EPSILON0-dev/pico-pdu/pcb/pico-pdu.kicad_pcb

## KiCad design pcb/pico-pdu.kicad_pcb (2026-10-05)

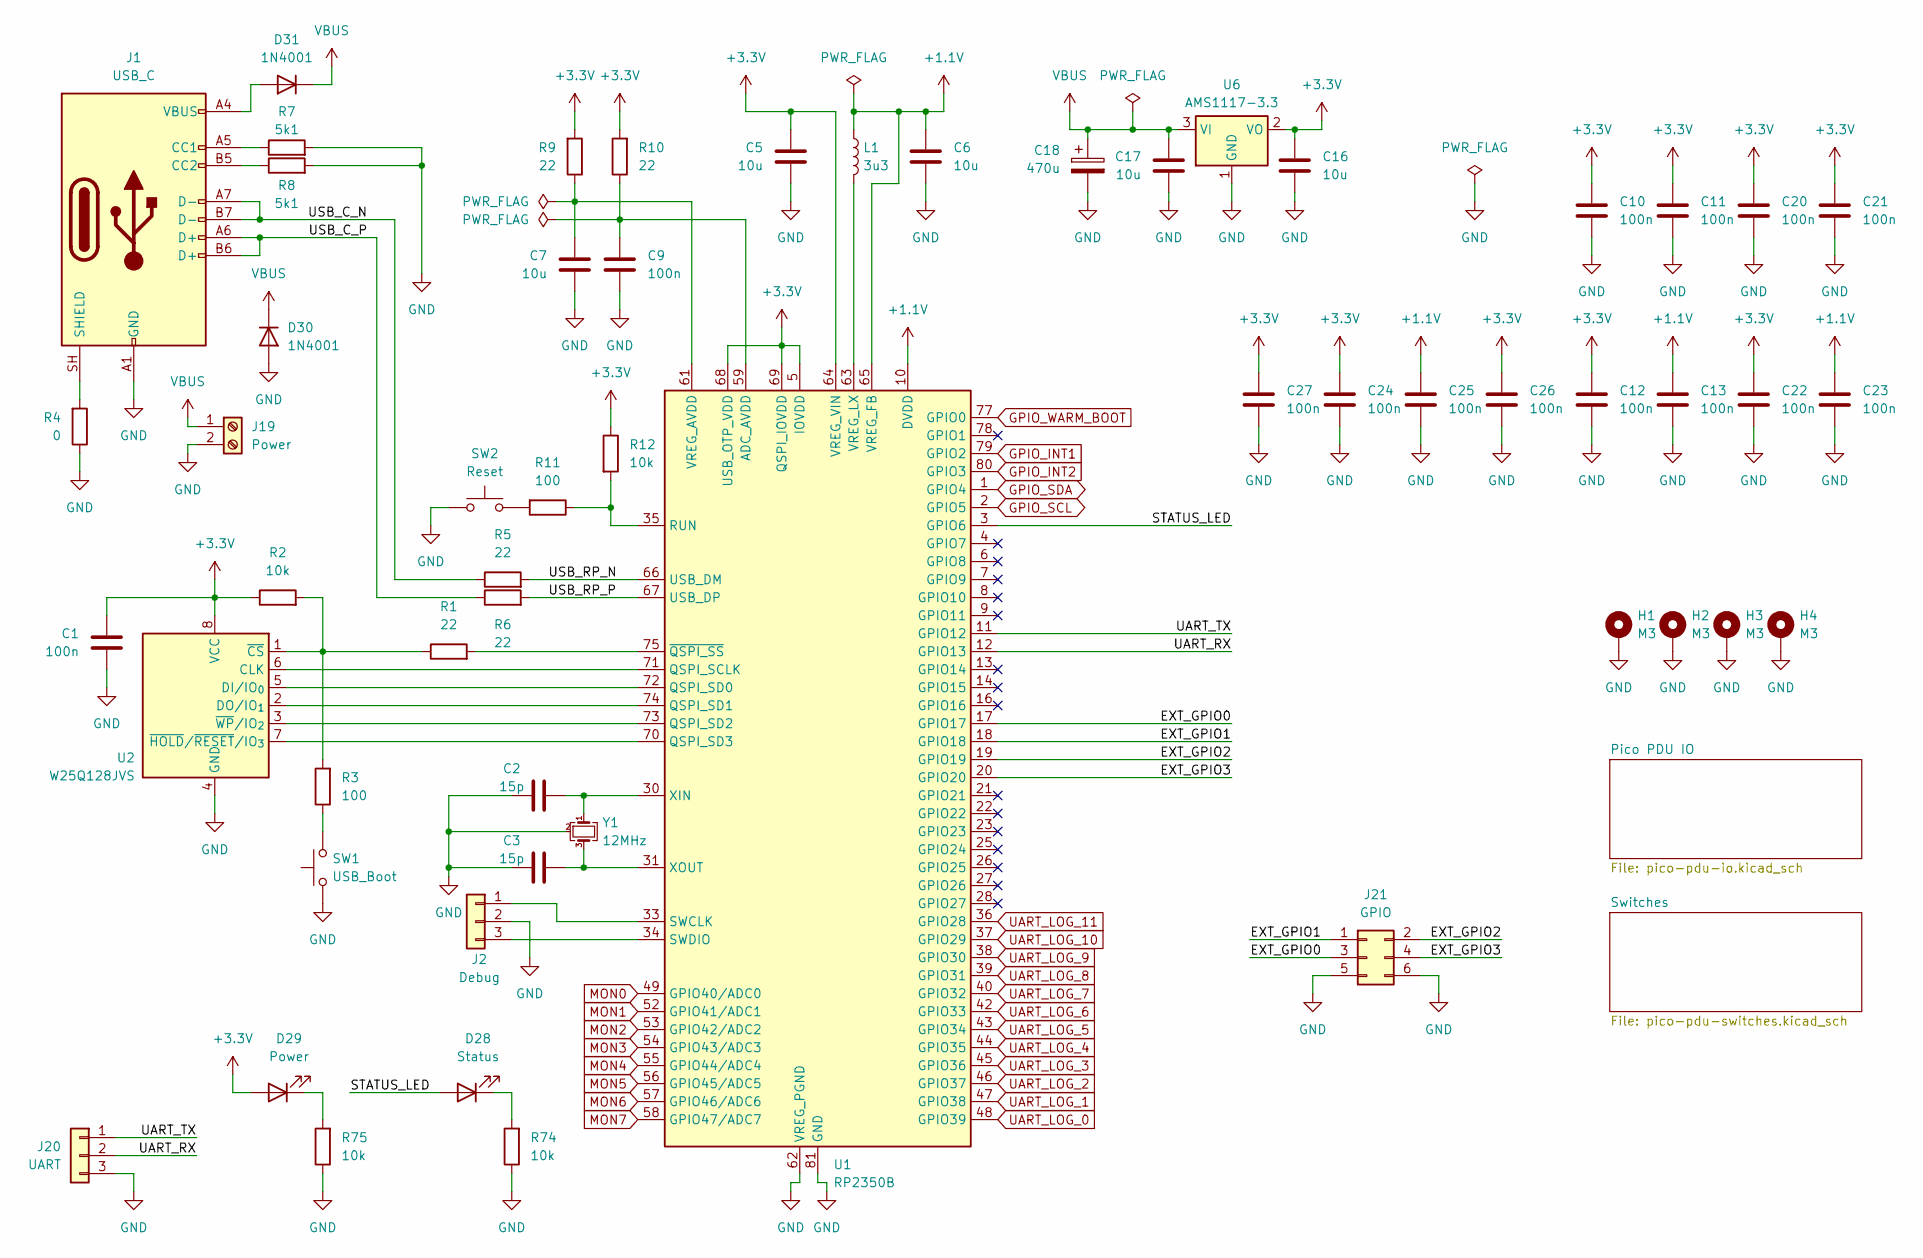
[picture p3: schematic pico-pdu.kicad_sch, Pico PDU MCU]

Parts:
C1, C9, C10, C11, C12, C13, C20, C21, C22, C23, C24, C25, C26, C27: 100n; C_0402_1005Metric
C2, C3: 15p; C_0402_1005Metric
C5, C6, C7, C16, C17: 10u; C_0603_1608Metric
C18: 470u; CP_Radial_D10.0mm_P5.00mm
D28: Status; LED_0805_2012Metric
D29: Power; LED_0805_2012Metric
D30, D31: 1N4001; D_DO-41_SOD81_P10.16mm_Horizontal
H1, H2, H3, H4: M3; MountingHole_3.2mm_M3_Pad_Via
J1: USB_C; USB_C_Receptacle_G-Switch_GT-USB-7010ASV
J2: Debug; PinHeader_1x03_P2.54mm_Vertical
J19: Power; TerminalBlock_MaiXu_MX126-5.0-02P_1x02_P5.00mm
J20: UART; PinHeader_1x03_P2.54mm_Vertical
J21: GPIO; PinHeader_2x03_P2.54mm_Vertical
L1: 3u3; L_1008_2520Metric
R1, R5, R6, R9, R10: 22; R_0402_1005Metric
R2, R12, R74, R75: 10k; R_0402_1005Metric
R3, R11: 100; R_0402_1005Metric
R4: 0; R_0402_1005Metric
R7, R8: 5k1; R_0402_1005Metric
SW1: USB_Boot; SW_Push_SPST_NO_Alps_SKRK
SW2: Reset; SW_Push_SPST_NO_Alps_SKRK
U1: RP2350B; QFN-80-1EP_10x10mm_P0.4mm_EP3.4x3.4mm
U2: W25Q128JVS; WSON-8-1EP_6x5mm_P1.27mm_EP3.4x4mm
U6: AMS1117-3.3; SOT-223-3_TabPin2
Y1: 12MHz; Crystal_SMD_2520-4Pin_2.5x2.0mm

Connections:
+1.1V: C6.1, C13.1, C23.1, C25.1, L1.1, U1.10 (DVDD), U1.32 (DVDD), U1.51 (DVDD), U1.65 (VREG_FB)
+3.3V: C1.1, C5.2, C10.1, C11.1, C12.1, C16.1, C20.1, C21.1, C22.1, C24.1, C26.1, C27.1, D29.2 (A), R2.1, R9.2, R10.2, R12.1, U1.5 (IOVDD), U1.15 (IOVDD), U1.24 (IOVDD), U1.29 (IOVDD), U1.41 (IOVDD), U1.50 (IOVDD), U1.60 (IOVDD), U1.64 (VREG_VIN), U1.68 (USB_OTP_VDD), U1.69 (QSPI_IOVDD), U1.76 (IOVDD), U2.8 (VCC), U6.2 (VO); also elsewhere on the board
/EXT_GPIO0: J21.3, U1.17 (GPIO17)
/EXT_GPIO1: J21.1, U1.18 (GPIO18)
/EXT_GPIO2: J21.2, U1.19 (GPIO19)
/EXT_GPIO3: J21.4, U1.20 (GPIO20)
/STATUS_LED: D28.2 (A), U1.3 (GPIO6)
/UART_RX: J20.2, U1.12 (GPIO13)
/UART_TX: J20.1, U1.11 (GPIO12)
/USB_C_N: J1.A7 (D-), J1.B7 (D-), R5.1
/USB_C_P: J1.A6 (D+), J1.B6 (D+), R6.1
/USB_RP_N: R5.2, U1.66 (USB_DM)
/USB_RP_P: R6.2, U1.67 (USB_DP)
GND: C1.2, C2.1, C3.1, C5.1, C6.2, C7.2, C9.2, C10.2, C11.2, C12.2, C13.2, C16.2, C17.2, C18.2, C20.2, C21.2, C22.2, C23.2, C24.2, C25.2, C26.2, C27.2, D30.2 (A), H1.1 (1_1), H2.1 (1_1), H3.1 (1_1), H4.1 (1_1), J1.A1 (GND), J1.A12 (GND), J1.B1 (GND), J1.B12 (GND), J2.2, J19.2, J20.3, J21.5, J21.6, R4.1, R7.2, R8.2, R74.1, R75.1, SW1.1, SW2.2, U1.62 (VREG_PGND), U1.81 (GND), U2.4 (GND), U6.1 (GND), Y1.2 (G), Y1.4 (G); also elsewhere on the board
GPIO_INT1: U1.79 (GPIO2); also elsewhere on the board
GPIO_INT2: U1.80 (GPIO3); also elsewhere on the board
GPIO_SCL: U1.2 (GPIO5); also elsewhere on the board
GPIO_SDA: U1.1 (GPIO4); also elsewhere on the board
GPIO_WARM_BOOT: U1.77 (GPIO0); also elsewhere on the board
MON0: U1.49 (GPIO40/ADC0); also elsewhere on the board
MON1: U1.52 (GPIO41/ADC1); also elsewhere on the board
MON2: U1.53 (GPIO42/ADC2); also elsewhere on the board
MON3: U1.54 (GPIO43/ADC3); also elsewhere on the board
MON4: U1.55 (GPIO44/ADC4); also elsewhere on the board
MON5: U1.56 (GPIO45/ADC5); also elsewhere on the board
MON6: U1.57 (GPIO46/ADC6); also elsewhere on the board
MON7: U1.58 (GPIO47/ADC7); also elsewhere on the board
unnamed: D28.1 (K), R74.2
unnamed: D29.1 (K), R75.2
unnamed: D31.2 (A), J1.A4 (VBUS), J1.A9 (VBUS), J1.B4 (VBUS), J1.B9 (VBUS)
unnamed: J1.A5 (CC1), R7.1
unnamed: J1.B5 (CC2), R8.1
unnamed: J1.SH (SHIELD), R4.2
unnamed: J2.1, U1.33 (SWCLK)
unnamed: J2.3, U1.34 (SWDIO)
unnamed: R3.1, SW1.2
unnamed: R11.2, SW2.1
unnamed: C9.1, R10.1, U1.59 (ADC_AVDD)
unnamed: U1.71 (QSPI_SCLK), U2.6 (CLK)
unnamed: U1.72 (QSPI_SD0), U2.5 (DI/IO_{0})
unnamed: U1.74 (QSPI_SD1), U2.2 (DO/IO_{1})
unnamed: U1.73 (QSPI_SD2), U2.3 (~WP/IO_{2})
unnamed: U1.70 (QSPI_SD3), U2.7 (~HOLD/~RESET/IO_{3})
unnamed: R11.1, R12.2, U1.35 (RUN)
unnamed: C7.1, R9.1, U1.61 (VREG_AVDD)
unnamed: L1.2, U1.63 (VREG_LX)
unnamed: C2.2, U1.30 (XIN), Y1.1
unnamed: C3.2, U1.31 (XOUT), Y1.3
unnamed: R1.2, U1.75 (~QSPI_SS)
unnamed: R1.1, R2.2, R3.2, U2.1 (~CS)
UART_LOG_0: U1.48 (GPIO39); also elsewhere on the board
UART_LOG_1: U1.47 (GPIO38); also elsewhere on the board
UART_LOG_2: U1.46 (GPIO37); also elsewhere on the board
UART_LOG_3: U1.45 (GPIO36); also elsewhere on the board
UART_LOG_4: U1.44 (GPIO35); also elsewhere on the board
UART_LOG_5: U1.43 (GPIO34); also elsewhere on the board
UART_LOG_6: U1.42 (GPIO33); also elsewhere on the board
UART_LOG_7: U1.40 (GPIO32); also elsewhere on the board
UART_LOG_8: U1.39 (GPIO31); also elsewhere on the board
UART_LOG_9: U1.38 (GPIO30); also elsewhere on the board
UART_LOG_10: U1.37 (GPIO29); also elsewhere on the board
UART_LOG_11: U1.36 (GPIO28); also elsewhere on the board
VBUS: C17.1, C18.1, D30.1 (K), D31.1 (K), J19.1, U6.3 (VI)

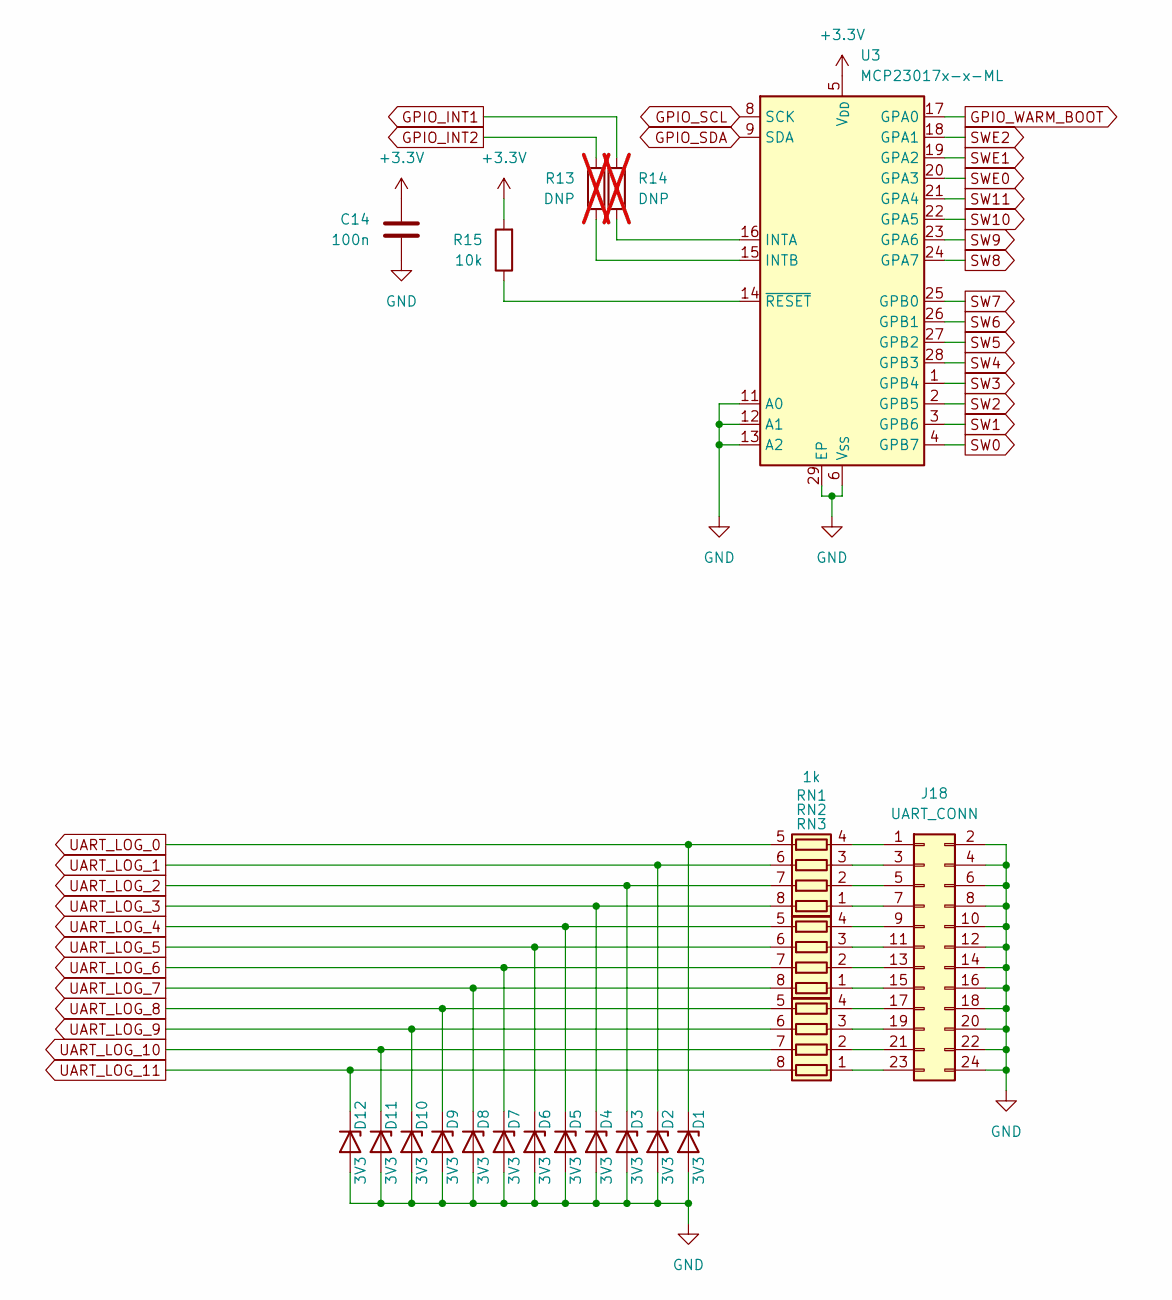
[picture p4: schematic pico-pdu-io.kicad_sch, Pico PDU IO]

Parts:
C14: 100n; C_0402_1005Metric
D1, D2, D3, D4, D5, D6, D7, D8, D9, D10, D11, D12: 3V3; D_MicroMELF
J18: UART_CONN; PinHeader_2x12_P2.54mm_Vertical
R13, R14: DNP; R_0402_1005Metric; not fitted
R15: 10k; R_0402_1005Metric
RN1, RN2, RN3: 1k; R_Array_Concave_4x0402
U3: MCP23017x-x-ML; QFN-28-1EP_6x6mm_P0.65mm_EP4.25x4.25mm

Connections:
+3.3V: C14.1, R15.2, U3.5 (V_{DD}); also elsewhere on the board
GND: C14.2, D1.2 (A), D2.2 (A), D3.2 (A), D4.2 (A), D5.2 (A), D6.2 (A), D7.2 (A), D8.2 (A), D9.2 (A), D10.2 (A), D11.2 (A), D12.2 (A), J18.2, J18.4, J18.6, J18.8, J18.10, J18.12, J18.14, J18.16, J18.18, J18.20, J18.22, J18.24, U3.6 (V_{SS}), U3.11 (A0), U3.12 (A1), U3.13 (A2), U3.29 (EP); also elsewhere on the board
GPIO_INT1: R14.2; also elsewhere on the board
GPIO_INT2: R13.2; also elsewhere on the board
GPIO_SCL: U3.8 (SCK); also elsewhere on the board
GPIO_SDA: U3.9 (SDA); also elsewhere on the board
GPIO_WARM_BOOT: U3.17 (GPA0); also elsewhere on the board
unnamed: J18.1, RN1.4 (R4.1)
unnamed: J18.3, RN1.3 (R3.1)
unnamed: J18.5, RN1.2 (R2.1)
unnamed: J18.7, RN1.1 (R1.1)
unnamed: J18.9, RN2.4 (R4.1)
unnamed: J18.11, RN2.3 (R3.1)
unnamed: J18.13, RN2.2 (R2.1)
unnamed: J18.15, RN2.1 (R1.1)
unnamed: J18.17, RN3.4 (R4.1)
unnamed: J18.19, RN3.3 (R3.1)
unnamed: J18.21, RN3.2 (R2.1)
unnamed: J18.23, RN3.1 (R1.1)
unnamed: R14.1, U3.16 (INTA)
unnamed: R13.1, U3.15 (INTB)
unnamed: R15.1, U3.14 (~RESET)
SW0: U3.4 (GPB7); also elsewhere on the board
SW1: U3.3 (GPB6); also elsewhere on the board
SW2: U3.2 (GPB5); also elsewhere on the board
SW3: U3.1 (GPB4); also elsewhere on the board
SW4: U3.28 (GPB3); also elsewhere on the board
SW5: U3.27 (GPB2); also elsewhere on the board
SW6: U3.26 (GPB1); also elsewhere on the board
SW7: U3.25 (GPB0); also elsewhere on the board
SW8: U3.24 (GPA7); also elsewhere on the board
SW9: U3.23 (GPA6); also elsewhere on the board
SW10: U3.22 (GPA5); also elsewhere on the board
SW11: U3.21 (GPA4); also elsewhere on the board
SWE0: U3.20 (GPA3); also elsewhere on the board
SWE1: U3.19 (GPA2); also elsewhere on the board
SWE2: U3.18 (GPA1); also elsewhere on the board
UART_LOG_0: D1.1 (K), RN1.5 (R4.2); also elsewhere on the board
UART_LOG_1: D2.1 (K), RN1.6 (R3.2); also elsewhere on the board
UART_LOG_2: D3.1 (K), RN1.7 (R2.2); also elsewhere on the board
UART_LOG_3: D4.1 (K), RN1.8 (R1.2); also elsewhere on the board
UART_LOG_4: D5.1 (K), RN2.5 (R4.2); also elsewhere on the board
UART_LOG_5: D6.1 (K), RN2.6 (R3.2); also elsewhere on the board
UART_LOG_6: D7.1 (K), RN2.7 (R2.2); also elsewhere on the board
UART_LOG_7: D8.1 (K), RN2.8 (R1.2); also elsewhere on the board
UART_LOG_8: D9.1 (K), RN3.5 (R4.2); also elsewhere on the board
UART_LOG_9: D10.1 (K), RN3.6 (R3.2); also elsewhere on the board
UART_LOG_10: D11.1 (K), RN3.7 (R2.2); also elsewhere on the board
UART_LOG_11: D12.1 (K), RN3.8 (R1.2); also elsewhere on the board

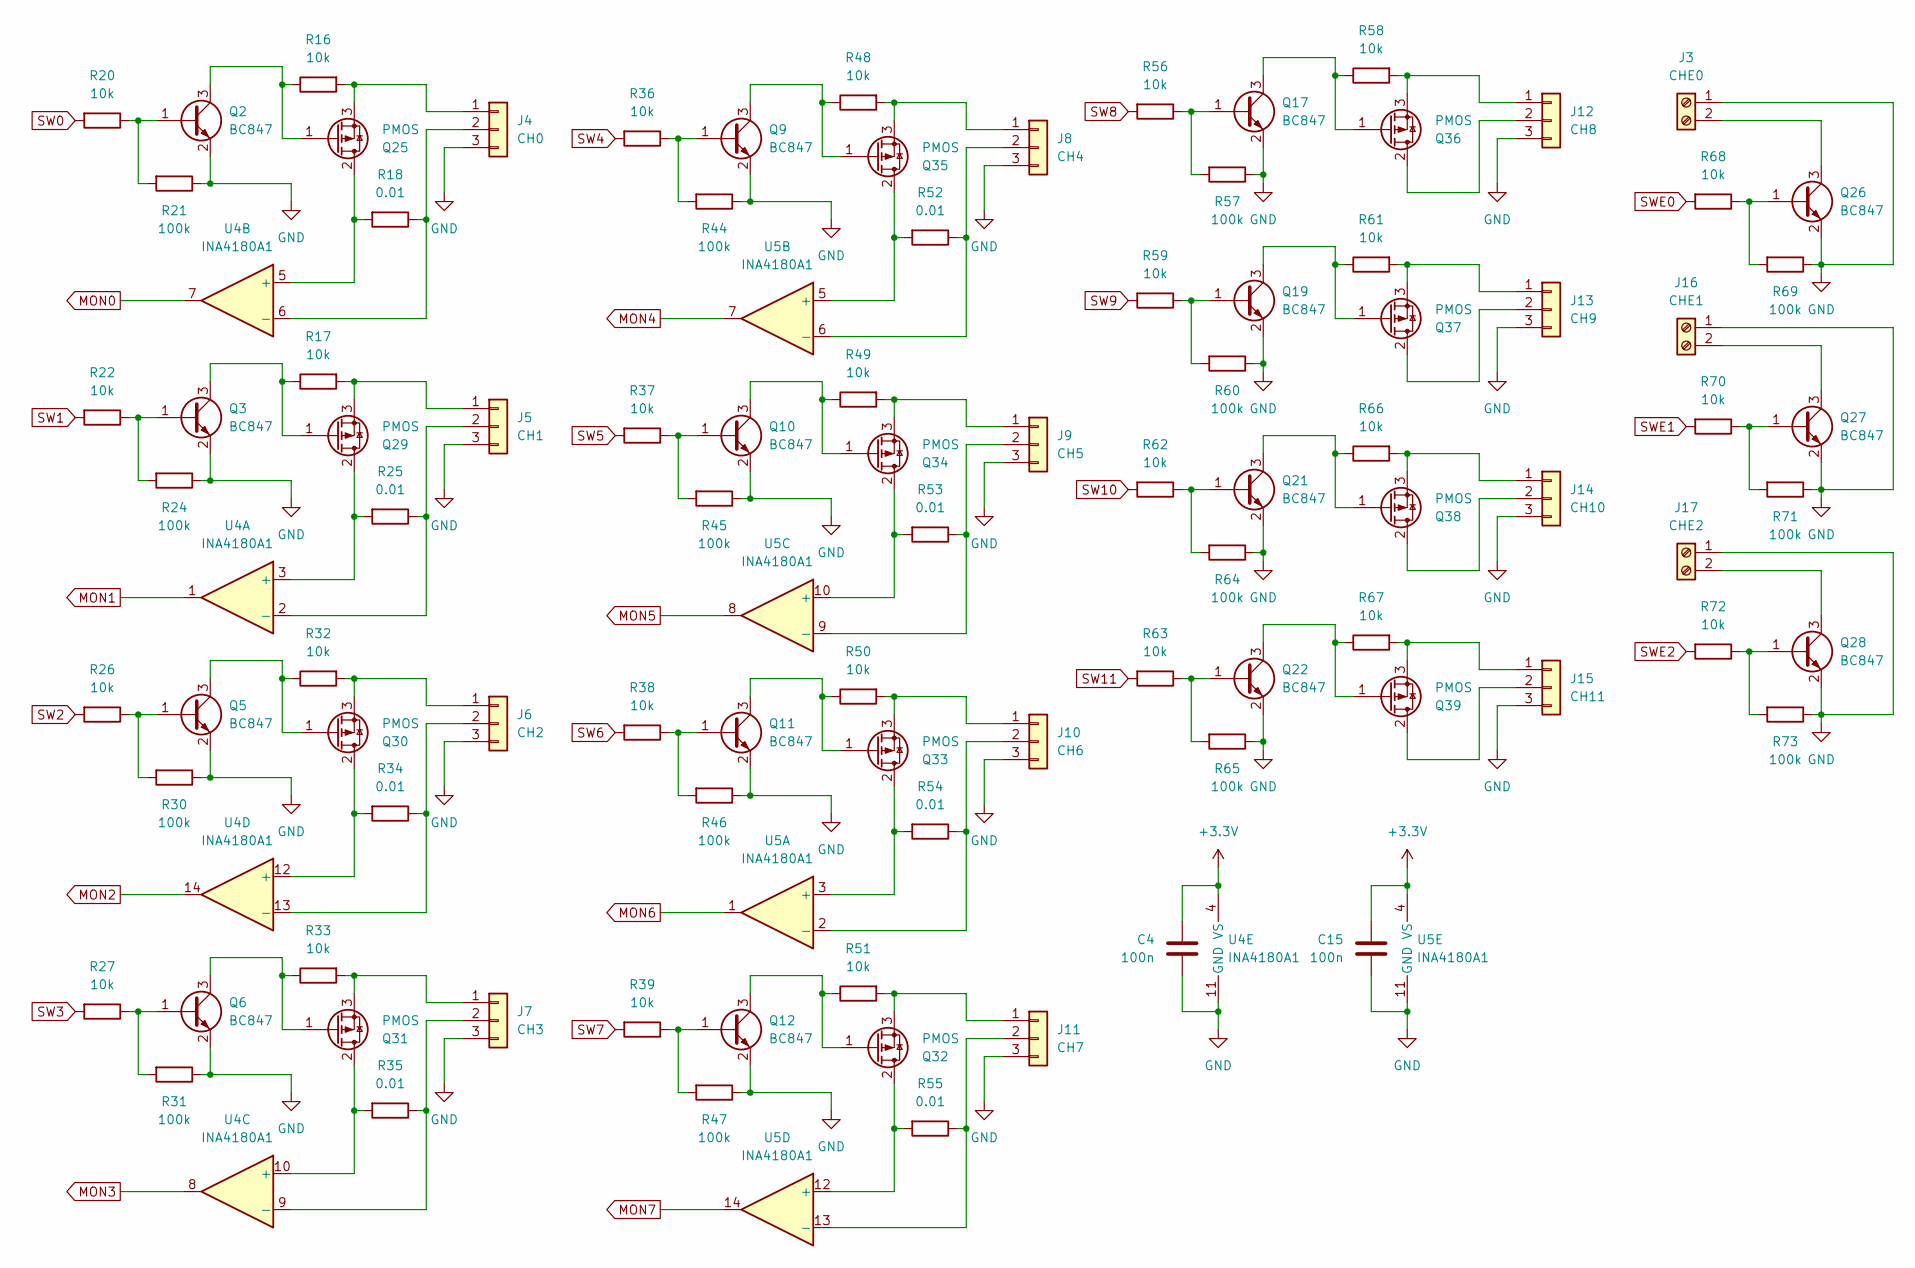
[picture p5: schematic pico-pdu-switches.kicad_sch, Pico PDU Switches]

Parts:
C4, C15: 100n; C_0402_1005Metric
J3: CHE0; TerminalBlock_MaiXu_MX126-5.0-02P_1x02_P5.00mm
J4: CH0; TerminalBlock_MaiXu_MX126-5.0-03P_1x03_P5.00mm
J5: CH1; TerminalBlock_MaiXu_MX126-5.0-03P_1x03_P5.00mm
J6: CH2; TerminalBlock_MaiXu_MX126-5.0-03P_1x03_P5.00mm
J7: CH3; TerminalBlock_MaiXu_MX126-5.0-03P_1x03_P5.00mm
J8: CH4; TerminalBlock_MaiXu_MX126-5.0-03P_1x03_P5.00mm
J9: CH5; TerminalBlock_MaiXu_MX126-5.0-03P_1x03_P5.00mm
J10: CH6; TerminalBlock_MaiXu_MX126-5.0-03P_1x03_P5.00mm
J11: CH7; TerminalBlock_MaiXu_MX126-5.0-03P_1x03_P5.00mm
J12: CH8; TerminalBlock_MaiXu_MX126-5.0-03P_1x03_P5.00mm
J13: CH9; TerminalBlock_MaiXu_MX126-5.0-03P_1x03_P5.00mm
J14: CH10; TerminalBlock_MaiXu_MX126-5.0-03P_1x03_P5.00mm
J15: CH11; TerminalBlock_MaiXu_MX126-5.0-03P_1x03_P5.00mm
J16: CHE1; TerminalBlock_MaiXu_MX126-5.0-02P_1x02_P5.00mm
J17: CHE2; TerminalBlock_MaiXu_MX126-5.0-02P_1x02_P5.00mm
Q2, Q3, Q5, Q6, Q9, Q10, Q11, Q12, Q17, Q19, Q21, Q22, Q26, Q27, Q28: BC847; SOT-23
Q25, Q29, Q30, Q31, Q32, Q33, Q34, Q35, Q36, Q37, Q38, Q39: PMOS; TO-252-3_TabPin2
R16, R17, R20, R22, R26, R27, R32, R33, R36, R37, R38, R39, R48, R49, R50, R51, R56, R58, R59, R61, R62, R63, R66, R67, R68, R70, R72: 10k; R_0402_1005Metric
R18, R25, R34, R35, R52, R53, R54, R55: 0.01; R_2512_6332Metric
R21, R24, R30, R31, R44, R45, R46, R47, R57, R60, R64, R65, R69, R71, R73: 100k; R_0402_1005Metric
U4, U5: INA4180A1; TSSOP-14_4.4x5mm_P0.65mm

Connections:
+3.3V: C4.1, C15.1, U4.4 (VS), U5.4 (VS); also elsewhere on the board
GND: C4.2, C15.2, J3.1, J4.3, J5.3, J6.3, J7.3, J8.3, J9.3, J10.3, J11.3, J12.3, J13.3, J14.3, J15.3, J16.1, J17.1, Q2.2 (E), Q3.2 (E), Q5.2 (E), Q6.2 (E), Q9.2 (E), Q10.2 (E), Q11.2 (E), Q12.2 (E), Q17.2 (E), Q19.2 (E), Q21.2 (E), Q22.2 (E), Q26.2 (E), Q27.2 (E), Q28.2 (E), R21.1, R24.1, R30.1, R31.1, R44.1, R45.1, R46.1, R47.1, R57.1, R60.1, R64.1, R65.1, R69.1, R71.1, R73.1, U4.11 (GND), U5.11 (GND); also elsewhere on the board
MON0: U4.7; also elsewhere on the board
MON1: U4.1; also elsewhere on the board
MON2: U4.14; also elsewhere on the board
MON3: U4.8; also elsewhere on the board
MON4: U5.7; also elsewhere on the board
MON5: U5.8; also elsewhere on the board
MON6: U5.1; also elsewhere on the board
MON7: U5.14; also elsewhere on the board
unnamed: J3.2, Q26.3 (C)
unnamed: J4.1, Q25.3 (S), R16.2
unnamed: J4.2, R18.1, U4.6 (-)
unnamed: J5.1, Q29.3 (S), R17.2
unnamed: J5.2, R25.1, U4.2 (-)
unnamed: J6.1, Q30.3 (S), R32.2
unnamed: J6.2, R34.1, U4.13 (-)
unnamed: J7.1, Q31.3 (S), R33.2
unnamed: J7.2, R35.1, U4.9 (-)
unnamed: J8.1, Q35.3 (S), R48.2
unnamed: J8.2, R52.1, U5.6 (-)
unnamed: J9.1, Q34.3 (S), R49.2
unnamed: J9.2, R53.1, U5.9 (-)
unnamed: J10.1, Q33.3 (S), R50.2
unnamed: J10.2, R54.1, U5.2 (-)
unnamed: J11.1, Q32.3 (S), R51.2
unnamed: J11.2, R55.1, U5.13 (-)
unnamed: J12.1, Q36.3 (S), R58.2
unnamed: J12.2, Q36.2 (D)
unnamed: J13.1, Q37.3 (S), R61.2
unnamed: J13.2, Q37.2 (D)
unnamed: J14.1, Q38.3 (S), R66.2
unnamed: J14.2, Q38.2 (D)
unnamed: J15.1, Q39.3 (S), R67.2
unnamed: J15.2, Q39.2 (D)
unnamed: J16.2, Q27.3 (C)
unnamed: J17.2, Q28.3 (C)
unnamed: Q2.1 (B), R20.1, R21.2
unnamed: Q2.3 (C), Q25.1 (G), R16.1
unnamed: Q3.1 (B), R22.1, R24.2
unnamed: Q5.1 (B), R26.1, R30.2
unnamed: Q6.1 (B), R27.1, R31.2
unnamed: Q9.1 (B), R36.1, R44.2
unnamed: Q10.1 (B), R37.1, R45.2
unnamed: Q10.3 (C), Q34.1 (G), R49.1
unnamed: Q11.1 (B), R38.1, R46.2
unnamed: Q11.3 (C), Q33.1 (G), R50.1
unnamed: Q12.1 (B), R39.1, R47.2
unnamed: Q12.3 (C), Q32.1 (G), R51.1
unnamed: Q17.1 (B), R56.1, R57.2
unnamed: Q17.3 (C), Q36.1 (G), R58.1
unnamed: Q19.1 (B), R59.1, R60.2
unnamed: Q19.3 (C), Q37.1 (G), R61.1
unnamed: Q21.1 (B), R62.1, R64.2
unnamed: Q21.3 (C), Q38.1 (G), R66.1
unnamed: Q22.1 (B), R63.1, R65.2
unnamed: Q22.3 (C), Q39.1 (G), R67.1
unnamed: Q25.2 (D), R18.2, U4.5 (+)
unnamed: Q26.1 (B), R68.1, R69.2
unnamed: Q27.1 (B), R70.1, R71.2
unnamed: Q28.1 (B), R72.1, R73.2
unnamed: Q29.2 (D), R25.2, U4.3 (+)
unnamed: Q3.3 (C), Q29.1 (G), R17.1
unnamed: Q30.2 (D), R34.2, U4.12 (+)
unnamed: Q5.3 (C), Q30.1 (G), R32.1
unnamed: Q31.2 (D), R35.2, U4.10 (+)
unnamed: Q6.3 (C), Q31.1 (G), R33.1
unnamed: Q32.2 (D), R55.2, U5.12 (+)
unnamed: Q33.2 (D), R54.2, U5.3 (+)
unnamed: Q34.2 (D), R53.2, U5.10 (+)
unnamed: Q35.2 (D), R52.2, U5.5 (+)
unnamed: Q9.3 (C), Q35.1 (G), R48.1
SW0: R20.2; also elsewhere on the board
SW1: R22.2; also elsewhere on the board
SW2: R26.2; also elsewhere on the board
SW3: R27.2; also elsewhere on the board
SW4: R36.2; also elsewhere on the board
SW5: R37.2; also elsewhere on the board
SW6: R38.2; also elsewhere on the board
SW7: R39.2; also elsewhere on the board
SW8: R56.2; also elsewhere on the board
SW9: R59.2; also elsewhere on the board
SW10: R62.2; also elsewhere on the board
SW11: R63.2; also elsewhere on the board
SWE0: R68.2; also elsewhere on the board
SWE1: R70.2; also elsewhere on the board
SWE2: R72.2; also elsewhere on the board

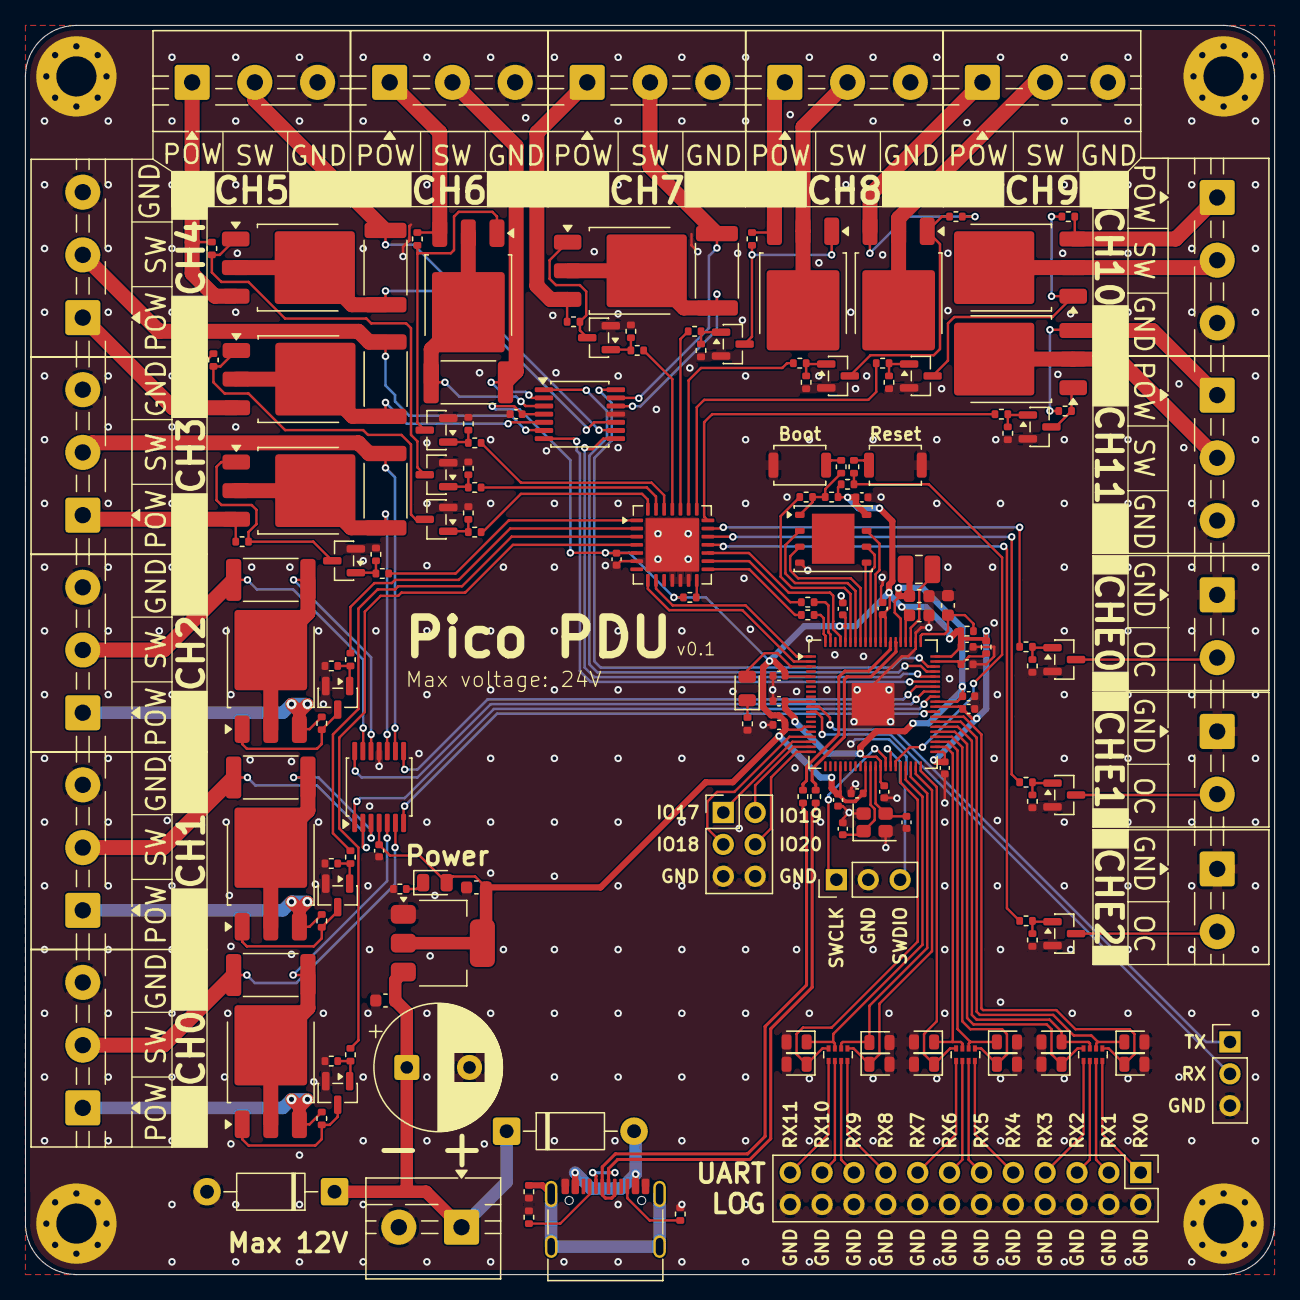
[picture p6: board pico-pdu.kicad_pcb from above]

Board: 2 copper layers, 99.6 x 99.6 mm, 173 parts (0 on the bottom side), 155 nets.
